ZSchneiderman/SDR-Senior-Design/docs/Video tutorial notes/Samuel_Set_2.jpg

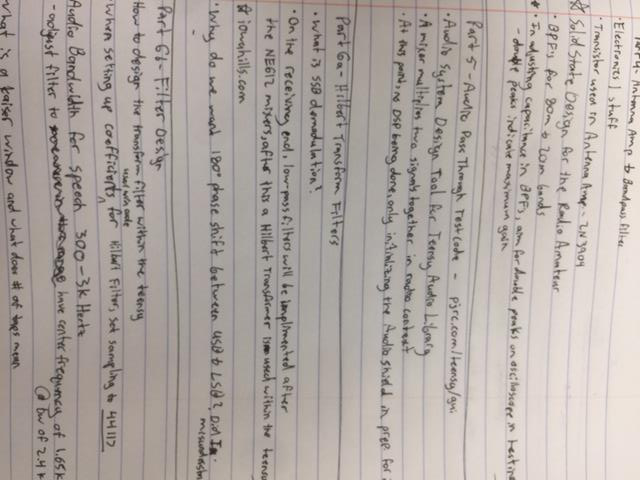
docs/Video tutorial notes/Samuel_Set_2.jpg
