ZSchneiderman/SDR-Senior-Design/docs/Video tutorial notes/Samuel_Set_3.jpg

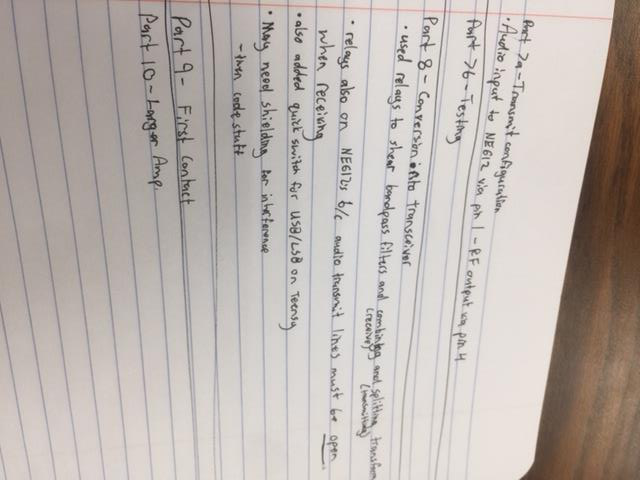
docs/Video tutorial notes/Samuel_Set_3.jpg
