ZSchneiderman/SDR-Senior-Design/docs/SDR_Code/ReadMe.txt

I have uploaded this as a zip file filled with text files because when I try to upload an
arduino file the texas state servers reject it as an "error code 0".
