ZSchneiderman/SDR-Senior-Design/docs/Weekly Reports/1_12_Weekly_12_5_2018.docx

1.12 | Weekly Status Report for Software Defined Radio
| December 5, 2018 | Submitted by: James Bell
| Faculty Advisor: Dr. Stapleton | Team Members: James Bell [PM] Samuel Hussey Zachary Schneiderman
| Sponsor: Texas State University

Green | Current Project Status

We are finalizing things for senior design day. Being the notebook, the mockup circuit, and the poster.

Activities/Accomplishments this week
Team Member | Description
James Bell | I am updating paperwork and compiling the binder for senior design day as well as helping label and compile the parts and sub-assemblies on a demonstration piece.
Samuel Hussey | Completed test plan and prepared documentation for binder.
Zachary Schneiderman | Completed individual report and prepared quadrature generator circuit for display.

Problems Encountered
Severity | Description
High | Still have not received the last of the toroid’s needed for the bandpass filter.
Med | .
Low | .

Activities planned for next week
Team Member | Description
James Bell | Finals.
Samuel Hussey | Assemble and test bp filters if parts arrive.
Zachary Schneiderman | Finish quadrature generator circuit for senior design display.

Upcoming Course Deliverables (next 2 to 3 weeks)
Deliverable | Due Date | Status

Sponsor and Faculty Advisor Meetings Held/Planned
Who | Date | Topic(s)
Dr. Aslan | Wednesdays, 8:20am | Weekly Meeting and discussion on project.
