ZSchneiderman/SDR-Senior-Design/docs/Weekly Reports/1_12_Weekly_11_28_2018.docx

1.12 | Weekly Status Report for Software Defined Radio
| November 28, 2018 | Submitted by: James Bell
| Faculty Advisor: Dr. Stapleton | Team Members: James Bell [PM] Samuel Hussey Zachary Schneiderman
| Sponsor: Texas State University

Green | Current Project Status

We are flying through the initial testing and assembly of our device but being seriously limited in the time we can work on the device due to the amount of paperwork needed of us these last 2 weeks.

Activities/Accomplishments this week
Team Member | Description
James Bell | I am updating paperwork and compiling the binder for senior design day as well as helping label and compile the parts and sub-assemblies on a demonstration piece. I am also writing my individual report.
Samuel Hussey | Worked on test plan and began individual report.
Zachary Schneiderman | Completed rough draft for Senior Design Day poster

Problems Encountered
Severity | Description
High
Med | Still have not received the last of the toroid’s needed for the bandpass filter.
Low | .

Activities planned for next week
Team Member | Description
James Bell | I am preparing for senior design day by completing the mountains of paperwork required of us in this short stretch of time.
Samuel Hussey | Finish test plan/individual report, assemble and test bandpass filters if parts arrive.
Zachary Schneiderman | Need to apply feedback to poster to have it fully ready for senior design day

Upcoming Course Deliverables (next 2 to 3 weeks)
Deliverable | Due Date | Status
Poster final | 11/30/18 | In progress
Test Plan | 11/30/18 | In progress
Individual Reports | 12/3/18 | In progress

Sponsor and Faculty Advisor Meetings Held/Planned
Who | Date | Topic(s)
Dr. Aslan | Wednesdays, 8:20am | Weekly Meeting and discussion on project.
