ZSchneiderman/SDR-Senior-Design/docs/Weekly Reports/1_12_Weekly_10_24_2018.docx

1.12 | Weekly Status Report for Software Defined Radio
| October 24, 2018 | Submitted by: James Bell
| Faculty Advisor: Dr. Stapleton | Team Members: James Bell [PM] Samuel Hussey Zachary Schneiderman
| Sponsor: Texas State University

Yellow | Current Project Status

We built the amplifier we designed using parts available on campus from the parts carts in RFM 5216 and compared the results to the simulation of the same design. The simulation and the actual build did not match at all and the gain dropped dramatically as the frequency was increased. We are researching the possible causes and new designs for the amplifier to eliminate this problem.

Activities/Accomplishments this week
Team Member | Description
James Bell | I am updating the signal flow chart, and submitting orders for parts so we may begin analog testing as soon as our parts are in.
Samuel Hussey | Modifications to functional spec sections. Prepared IDR presentation.
Zachary Schneiderman | Finished functional spec, experimented on a breadboard with amplifier

Problems Encountered
Severity | Description
High | Pre-designed amplifiers do not have the frequency response we desire. The 80m and 40m bandpass filters do not have the roll-off characteristics we desire, so a redesign for all those components is necessary.
Med | We are unsure which type of inductor to get/build for our project as we have received multiple differing opinions on it, we are doing extra research in to it now.
Low | LTSpice testing shows that amplifier maintains gain with increase in frequency but in circuit tests show that in drops significantly.

Activities planned for next week
Team Member | Description
James Bell | Updating the functional schematic to fix errors pointed out in the functional design review, and studying digital signal processing.
Samuel Hussey | Start construction of analog components to begin in circuit testing.
Zachary Schneiderman | Update parts list, and prepare/practice for design review

Upcoming Course Deliverables (next 2 to 3 weeks)
Deliverable | Due Date | Status
Functional Specifications | 10/15/18 | Complete

Sponsor and Faculty Advisor Meetings Held/Planned
Who | Date | Topic(s)
Dr. Aslan | Wednesdays, 8:20am | Weekly Meeting and discussion on project.

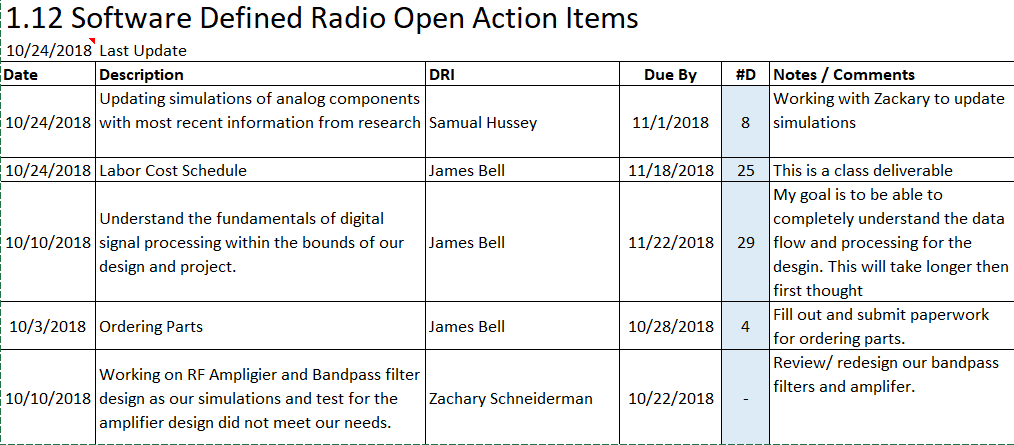
[picture p19: figure]
