ZSchneiderman/SDR-Senior-Design/docs/Block Diagram.docx

LCD

SN74HC74

LPF

LPF

Amp

Mic

Teensy

SI5351

Audio Shield

Encoder

Amp

Ant.

Audio Transformer1k:1k in 600:600 out

Audio Transformer1k:1k in 600:600 out

Mixer

Mixer

RF Splitter/Combiner

BP Filter
