ZSchneiderman/SDR-Senior-Design/docs/Weekly Reports/1_12_Weekly_9_19_2018.pdf

# 1.12 Weekly Status Report for Software Defined Radio

September 19, 2018 | Submitted by: James Bell
Faculty Advisor: Dr. Stapleton | Team Members: James Bell [PM] Samuel Hussey Zachary Schneiderman

Sponsor: Texas State University

# Green Current Project Status

We have compiled the statement of work and will be getting it signed and finalized then the next set of necessary actions as of Wednesday 9/24/2018.

# Activities/Accomplishments this week

Team Member | Description
James Bell | Filled out project manager forms, documentation, started research in to
the Arduino testing environment and possible methods of testing the code provided with an actual micro controller.
Samuel Hussey | Began piecing together block diagrams to start working schematic in
LTSpice. Started building/finding components on LTSpice that are not originally included (mixers and antenna specifically).
Zachary Schneiderman Took notes and did research on unknowns from Charlie Morris’s SDR project, particularly Class B Amplifier design and quadrature audio signals

# Problems Encountered

Severity | Description
High | Not sure how to model/replace Teensy or audio board in LTSpice in
order to finish working model. Med
Low | How to use Piazza to upload and maintain documentation for the
project.

# Activities planned for next week

Team Member | Description
James Bell | Submit final signed version of the statement of work, then work out the
Arduino environment for code implementation and testing.
Samuel Hussey | Continue work on schematic by finishing finding/building any
components necessary and then implementing them into the schematic.

Zachary Schneiderman Start on first draft for parts list, need to do more research quadrature on refresh my self on DSP filters and transforms

# Upcoming Course Deliverables (next 2 to 3 weeks)

Deliverable | Due Date | Status
SOW | 9/24/2018 | In progress

# Sponsor and Faculty Advisor Meetings Held/Planned

Who | Date | Topic(s)
Dr. Aslan | Wednesdays, 8:20am | Weekly Meeting and discussion on project.

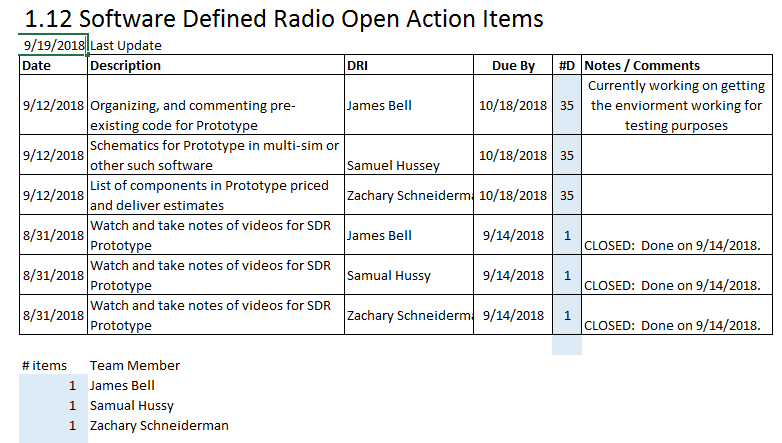
[picture p27: figure]

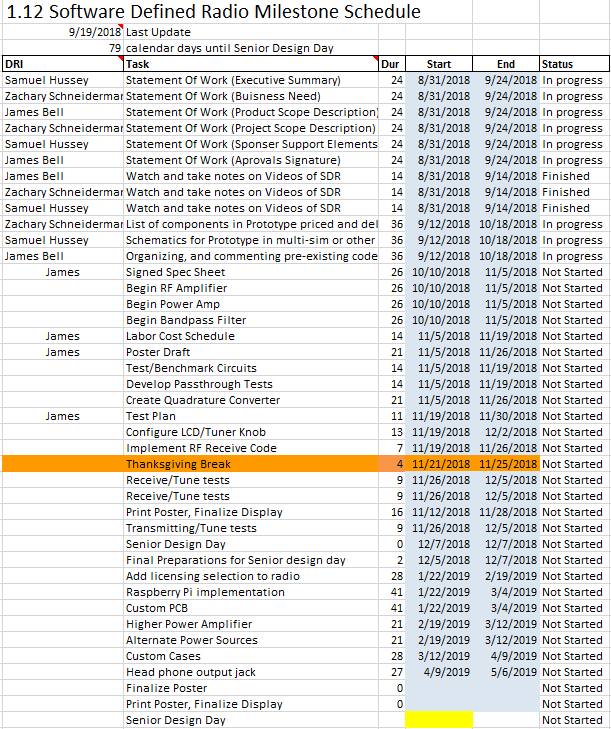
[picture p28: figure]
