ZSchneiderman/SDR-Senior-Design/docs/Weekly Reports/1_12_Weekly_9_26_2018.pdf

# 1.12 Weekly Status Report for Software Defined Radio

September 26, 2018 | Submitted by: James Bell
Faculty Advisor: Dr. Stapleton | Team Members: James Bell [PM] Samuel Hussey Zachary Schneiderman

Sponsor: Texas State University

# Green Current Project Status

We have submitted the statement of work and are now starting on our individual tasks as assigned in the action items.

# Activities/Accomplishments this week

Team Member | Description
James Bell | Downloaded, compiled, and began testing the Arduino environment.
Samuel Hussey | Continued progress on working schematic in LTSpice and began testing
amplifiers
Zachary Schneiderman Tried reading about quadrature audio, more complicated than thought

# Problems Encountered

Severity | Description
High | Not sure how to model/replace Teensy or audio board in LTSpice in
order to finish working model. Med
Low | .

# Activities planned for next week

Team Member | Description
James Bell | Begin reviewing the code provided and start working on implementing it
in the Arduino coding environment.
Samuel Hussey
Finish all diagrams and have specific components in place. Zachary Schneiderman Begin work on the parts list, ideally finish it

# Upcoming Course Deliverables (next 2 to 3 weeks)

Deliverable | Due Date | Status
SOW | 9/24/2018 | Completed

Functional

Specifications | 10/15/18 | In Progress

# Sponsor and Faculty Advisor Meetings Held/Planned

Who | Date | Topic(s)
Dr. Aslan | Wednesdays, 8:20am | Weekly Meeting and discussion on project.

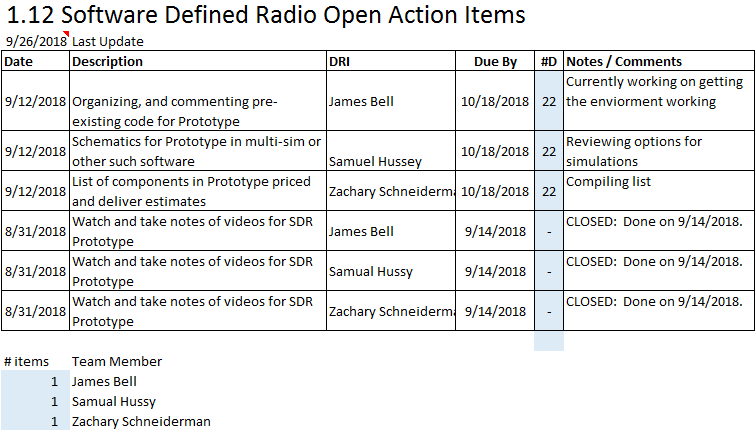
[picture p29: figure]

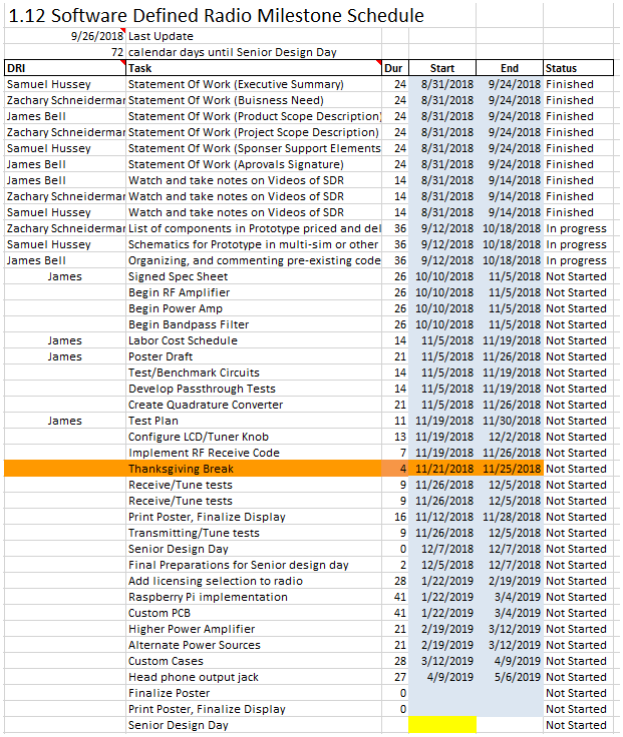
[picture p30: figure]
