ZSchneiderman/SDR-Senior-Design/docs/Weekly Reports/1_12_Weekly_9_12_2018.pdf

# 1.12 Weekly Status Report for Software Defined Radio

September 12, 2018 | Submitted by: James Bell
Faculty Advisor: Dr. Stapleton | Team Members: James Bell [PM] Samuel Hussey Zachary Schneiderman

Sponsor: Texas State University

# Green Current Project Status

We have delegated the statement of work out to individual team members and will be comparing rough drafts of each segment Wednesday 9/12/2018 to critique them, correct them and then send them to Dr. Aslan and Dr. Stapleton for review.

# Activities/Accomplishments this week

Team Member | Description
James Bell | Filled out project manager forms, documentation, completed the rough
draft of my section and found the prototype makers blog with rough documentation of the prototype.
Samuel Hussey | Worked on executive summary and sponsor support elements of
statement of work. Began research on mixers and filtering for receiver portion of radio.
Zachary Schneiderman Worked on first draft for the Business Need and Project Description sections of the statement of work. Started research on efficient amplifiers, and construction of custom inductors.

# Problems Encountered

Severity | Description
High | Charlie Morris is very Australian and his accent and the speed with which
he talks makes following the videos accurately difficult. Med
Low | Another series of Charlie Morris is more descriptive and in-depth, but
does not follow exactly what we will be constructing, so trying to translate the other projects design, to our own.

# Activities planned for next week

Team Member | Description
James Bell | Complete final Draft of assigned segments for the Statement of work,
and compile to finalized version of the statement of work for submission.

Samuel Hussey | Complete final draft of assigned segments of statement of work, start
constructing schematics in LTSpice.
Zachary Schneiderman Complete final draft of assigned sections of the Statement of Work. Start preparing parts list, and ensure everyone can set up the Arduino Suite.

# Upcoming Course Deliverables (next 2 to 3 weeks)

Deliverable | Due Date | Status
SOW | 9/24/2018 | In progress

# Sponsor and Faculty Advisor Meetings Held/Planned

Who | Date | Topic(s)
Dr. Stapleton | 9/6/2018 | Statement of Work advice, expectations, and commentary

Dr. Aslan and Dr.

Stapleton | 9/14/2018 | Statement of Work review

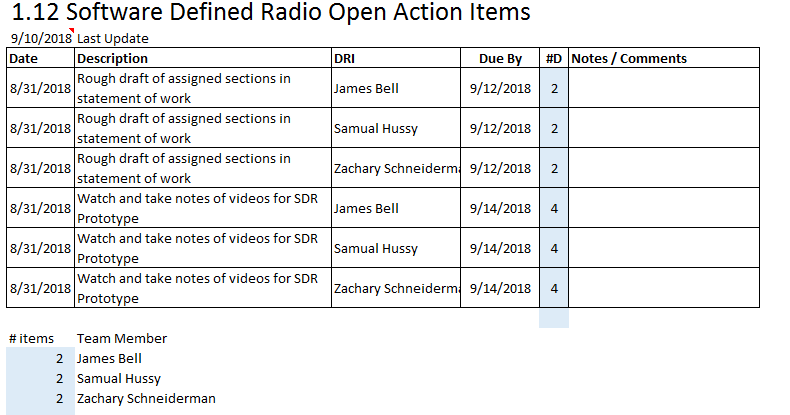
[picture p31: figure]

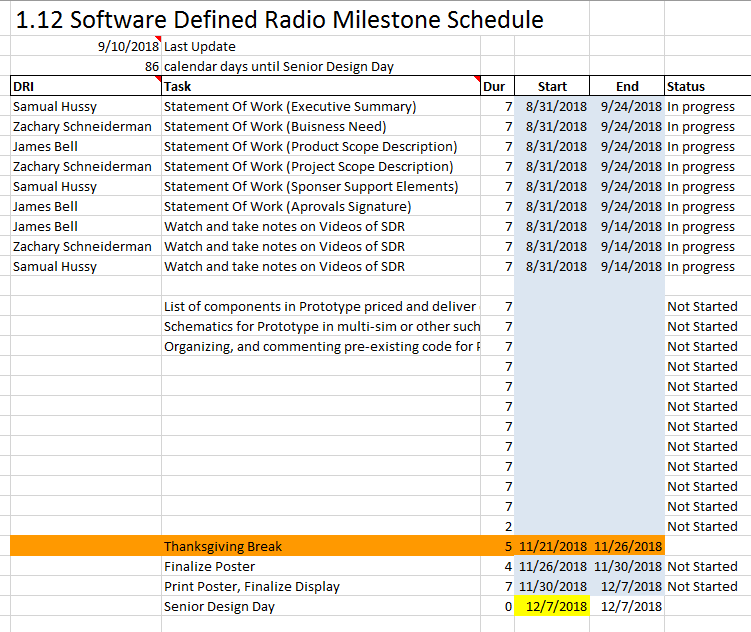
[picture p32: figure]
