ZSchneiderman/SDR-Senior-Design/docs/Labor Cost Schedule/Labor-Cost-Schedule Team 1.12.docx

Labor, Cost & Schedule Document

Software defined radio

Project Manager: James Bell

Samuel Hussey, Zachary Schneiderman

Texas State University

Ingram School of Engineering

SPONSOR Texas State University

601 University Drive

San Marcos, Texas, 78666

11/1/2018

Texas_State_Primary_V_2color

# 1 Introduction & Summary

In this Project the end goal is an operational software defined radio for educational

purposes. It will be a half-duplex device operating in the North American High

Frequency Range as allocated by the North American International Telecommunications Union. The radio will be completed by May 1st, 2019. The estimated cost for Labor is $52,016.48 and the estimated cost for Materials is $200.

# 2 Labor

## 2.1 Labor Categories

Project Labor Categories
Labor Category | Justification
Design Engineer | Optimization of radio frequency interactions with and between components.
Lawyer specializing in the FCC | Radio communications in the united states are regulated, and many laws apply to their use, it is important to know exactly what all of those are and how to go about designing the radio within legal bounds
Digital Signal Processing Engineer | As much of the fundamental filtering and operation of the radio will be done inside the digital realm of the
Test Engineer | Verifying the design is operating correctly and with in applicable law.
Technical Writer | Create a detailed and user-friendly user manual for device.
Technician | This will be necessary of a build kit goes in to production. A technician will need to be present to keep an eye on the production line.
Fabricator/Assembler | Needed to assemble the prototypes for testing.
Drafting / CAD | Creating clear and concise schematics for the user’s manual.
Marketing Analyst | Identifying the best methods to market the radio to those whom would be interested in buying it.
Administrative | Not needed as the device does not have administrative access.
Management / Supervision | Organizing contracts, setting time tables for stages of project, and facilitating funding.
Digital Signal Processing specialist | Need to create and optimize the digital signal processing done inside the device to limit radio latency.
Consulting | Not needed
Contractor | Not needed
Janitorial Services | Keeping a clean work space is very important to productivity, no one wants to work surrounded by filth.

## 2.2 Labor Rates

I have listed the burdened hourly cost as double the average hourly wage for each of those job titles in the united states as these tasks are not going to take a particularly long time. Meaning each of these jobs will not take an entire year thus hiring by task with a short term contract makes more economic sense then hiring for an entire year.

Labor Categories and Burdened Hourly Costs
Labor Category | Burdened Hourly Cost | Justification
Design Engineer | $77.06 | On average Radio Frequency design engineers make $80,140 a year, as this device should not take more then a year in development and testing, and the engineer will not be needed for that time it could be a short-term contract. Unfortunately, those type of contracts tend to be more hourly then the annual salary, thus the burdened hourly cost.
Lawyer specializing in the Federal Communications Commission | $114.63 | As this radio is being designed for the United states market it is important all laws, rules, and regulations are followed. To do this a lawyer specializing in those things with respect to the FCC is necessary for a legal radio.
Digital Signal Processing Engineer | $82.55 | As the fundamental filtering and operation of this device takes place digitally through digital signal processing this job is necessary and vital.
Test Engineer | $63.80 | Detailed and extensive testing of radios are necessary to ensure the radio meets federal and state laws and fall within those limits and bounds.
Technical Writer | $70.35 | A technical writer is vital whether we are making a build kit or just posting schematics for sale because if few can understand the design, then few will buy or build it. As this is not a project that needs full time employment paying for a contract-based job at the burden rate could be cheaper over all.
Technician | $41.17 | This cost will only be necessary if a radio build kit for our design goes in to production, but if it does it is important the production line does not go down, thus the Technician for as long as is needed.
Fabricator / Assembler | $30.77 | This person can be brought on as needed for hourly pay or a contract job, This persons duty is to assemble one or a set number of radios for testing, and as that number is variable and the time required may be limited the burdened hourly cost could be manageable.
Drafting / CAD | $52.16 | This job is necessary for the creation of schematics for this radio, as the placement of the components will affect the radios harmonics, and internal radio frequency interference this person should work closely with the radio frequency design engineer for placement and many of these schematics will be presented to the user to facilitate assembly. Thus, paying the burdened hourly cost to keep on a qualified and competent Drafter is vital.
Marketing Analyst | $60.15 | This job is important as it will provide information as to where to market our radio to attract the intended audience. Having a market analyst is important for the product to even get off the ground.
Administrative | ----- | This job is not required as administrative access for this radio does not exist.
Management / Supervision | $64.44 | Organizing contracts, setting time tables for stages of the project, and facilitating funding are all things necessary to the completion and distribution of the radio, Thus having one person whom the team can turn to for leadership and consistency is important.
Janitor | $27.71 | This is important to keep the work space clean and sanitary.

## 2.3 Total Cost of Labor

# 3 Materials

## 3.1 Capital Expenses

CAPITAL EXPENDITURE ESTIMATE
Task | Materials | Cost
Project Test | Mixed Signal Oscilloscope | $5,500¹
| Spectrum Analyzer | $8,000¹
TOTAL | | $13,500

¹ Available from Sponsor

² Available at Texas State University

## 3.2 Non-Capital Expenses

NON-CAPITAL EXPENDITURE ESTIMATE
Task | Materials | Cost
Project Fabrication | Soldering Station | $150
| Solder kit | $20
| Cables | $100
| IC's | $50
| Perf Board | $40
Project Test | Variable Power Supply (DC) | $200
| Function Generator (DC+AC) | $800
TOTAL | | $1360

# 4 Total Project Cost

PROJECT LABOR & MATERIALS COST SUMMARY
Cost Category | Estimated Cost
Labor | $52,016.48
Capital Expenses | $13,500.00
Non-Capital Expenses | $136.00
TOTAL ESTIMATED PROJECT COST | $65,652.48

# 6 Project Schedule

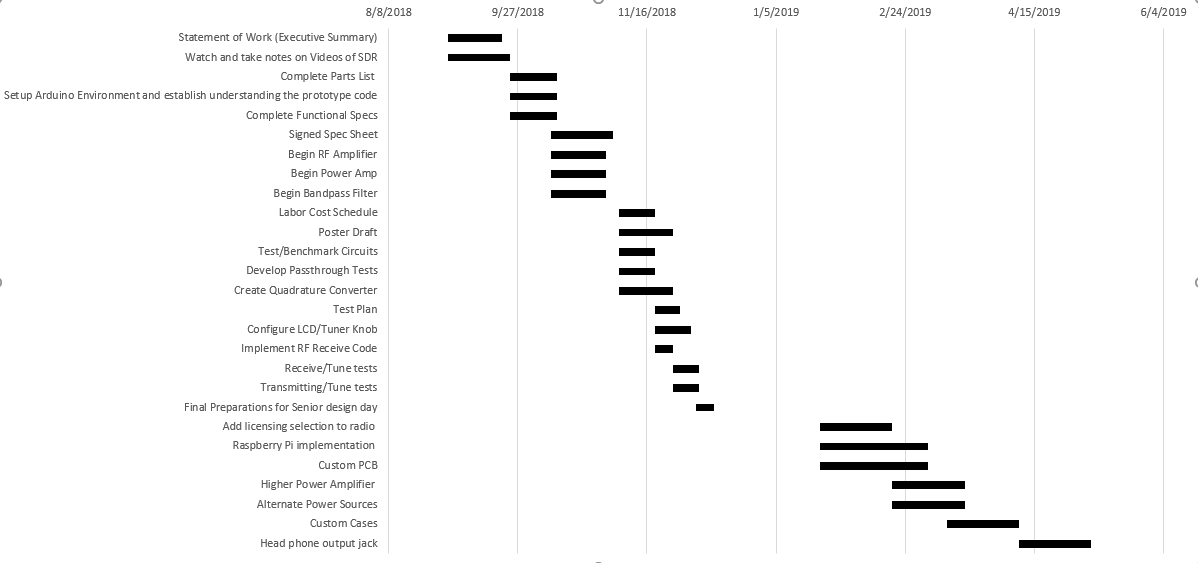
[picture p40: figure]

# 7 Approvals

Approver Name | Title | Signature | Date
| Project Manager
| D2 Project Manager
