ZSchneiderman/SDR-Senior-Design/docs/Labor Cost Schedule/Labor_Cost_Schedule.xlsx

Labor Estimate
 | Radio Freqency Design Engineer | Lawyer specializing in The FCC | Digital Signal Processing Engineer | Test Engineer | Technical Writer | Technician | Fabricator/Assembler | Drafting/CAD | Marketing Analyst | Management/Supervison | Cleaning/ Janitorial services | Total cost per stage
Burdened Hourly Rate | $77.06 | $114.63 | $82.55 | $63.80 | $70.35 | $41.17 | $30.77 | $52.16 | $60.15 | $64.44 | $27.71
Task | Hours Required
Project Definition | 40 | 40 |  |  |  |  |  |  | 10 | 22.5 |  | $9719.00
Legal documents | 4 | 60 |  |  |  |  |  |  | 4 | 17 |  | $8522.12
Functional Specification | 40 | 4 | 40 |  | 8 |  |  | 10 |  | 25.5 |  | $9570.54
Simulations | 10 |  | 40 | 6 |  |  |  |  |  | 14 |  | $5357.56
Test Plan | 20 |  | 20 | 40 | 8 |  |  |  |  | 22 |  | $7724.68
Prototype Assembly |  |  |  |  |  | 16 | 20 |  |  | 9 |  | $1854.08
Characterization | 10 |  |  | 40 |  |  |  |  |  | 12.5 |  | $4128.10
User Manual |  | 4 |  |  | 10 |  |  | 30 | 10 | 13.5 |  | $4198.26
Cleaning Services |  |  |  |  |  |  |  |  |  |  | 34 | $942.14
 |  |  |  |  |  |  |  |  | Total Burdened Cost = |  |  | $52016.48
Total number of hours in project = |  |  | 680
