ZSchneiderman/SDR-Senior-Design/docs/Video tutorial notes/Zach.pdf

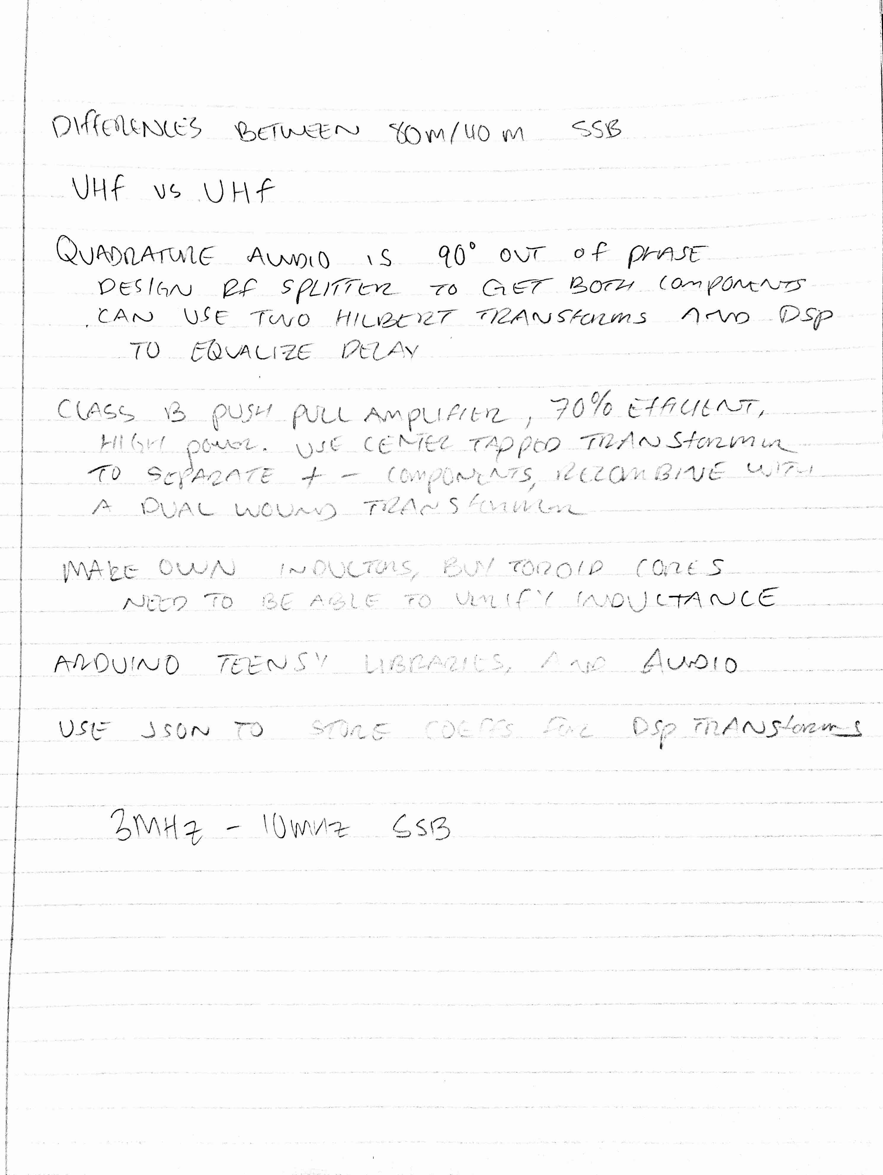
[picture p41: page 1]
