ZSchneiderman/SDR-Senior-Design/docs/Video tutorial notes/Samuel_Set_1.jpg

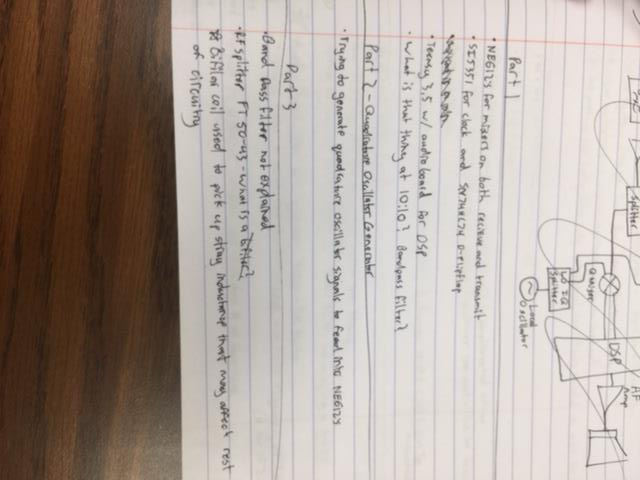
docs/Video tutorial notes/Samuel_Set_1.jpg
