ZSchneiderman/SDR-Senior-Design/(threads)

Thread 3 (2018-09-06):

Circuit Schematics

ZSchneiderman, 2018-09-06:
Need to create schematics for the teensy audio circuit, audio amplifier, microphone amplifier, digital to analog converters, filters, etc
