ZSchneiderman/SDR-Senior-Design/docs/Signal Flow Chart.pdf

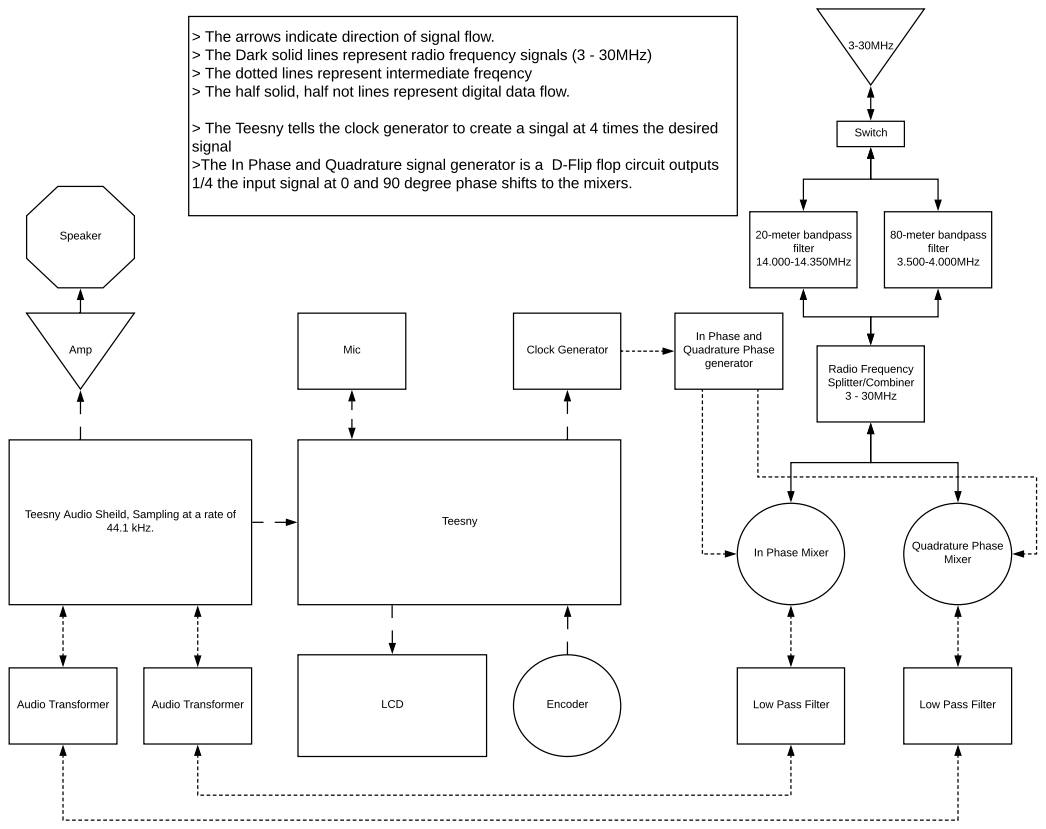
[picture p44: page 1]
3-30MHz; Switch; 20-meter bandpass filter 14.000-14.350MHz; 80-meter bandpass filter 3.500-4.000MHz; Radio Frequency Splitter/Combiner 3 - 30MHz; In Phase Mixer; Quadrature Phase Mixer; Audio Transformer; Low Pass Filter; 44.1 kHz.; Teesny; LCD; Encoder; Clock Generator; Amp; Mic; Speaker

> The arrows indicate direction of signal flow.
> The Dark solid lines represent radio frequency signals (3 - 30MHz)
> The dotted lines represent intermediate freqency
> The half solid, half not lines represent digital data flow.

> The Teesny tells the clock generator to create a singal at 4 times the desired
signal
>The In Phase and Quadrature signal generator is a D-Flip flop circuit outputs
1/4 the input signal at 0 and 90 degree phase shifts to the mixers.

In Phase and
Quadrature Phase
generator

Teesny Audio Sheild, Sampling at a rate of
