ZSchneiderman/SDR-Senior-Design/docs/LTspice schematics/7v_Regulator.asc

R1: res; 1000
R2: res; 220
X1: LM317T
Named nets: 7V_+, 12V_+, 0
