ZSchneiderman/SDR-Senior-Design/docs/LTspice schematics/80m_20m BPFs.asc

X1: 
X2: 
X3: 
X4: 
Named nets: Control_From_Teensy_Pin_30, Filtered_RF_out, Control_From_Teensy_Pin_31
