ZSchneiderman/SDR-Senior-Design/docs/LTspice schematics/Antenna & Amp.asc

C1: cap; 100n
C4: cap; 10n
C10: cap; 100n
Cb1: cap; 100n
L1: ind; 1mH
Q1: npn; 2N3904
R1: res; 10k
R2: res; 2k
R3: res; 2.2k
R5: res; 10k
RE1: res; 120
V1: voltage; 12V
Vs1: voltage; SINE(0 5uV 3.7e6 0 0 0); AC 1 0
X1: 
Named nets: 0, RF_Output, RF_Transmit_From_Mixing_Circuit, Control_From_Teensy_Pin_32
Antenna
RF Amp
