ZSchneiderman/SDR-Senior-Design/docs/LTspice schematics/Audio_Amp_to_Speaker.asc

X1: Audio_Amplifier
X2: Speaker
Named nets: AF_From_Mixing_Circuit, 5V_Source_+, gnd
