ZSchneiderman/SDR-Senior-Design/docs/LTspice schematics/LP_Filter.asc

C1: cap; 100n
C2: cap; 100n
L1: ind; 1m
Named nets: IN, Out, 0
