ZSchneiderman/SDR-Senior-Design/docs/LTspice schematics/Mixing Circuit.asc

C1: cap; 100n
C2: cap; 100n
C3: cap; 10µ
C4: cap; 10µ
C5: cap; 100n
C6: cap; 100n
R1: res; 4.7k
R2: res; 4.7k
X1: 
X2: 
X3: 
X4: 
X5: 
X6: 
X7: 
X8: 
X9: 
Named nets: Audio_Frequency_to_Audio_Amp, Filtered_RF_Input, RF_Transmit_to_Relay, 5V, Teensy_Pin_18, Teensy_Pin_19
