ZSchneiderman/SDR-Senior-Design/docs/LTspice schematics/SDR Transceiver Full.asc

X1: 
X2: 
X3: 
X4: 
X5: 
X6: 
X7: 
X8: 
Named nets: 5V
