ZSchneiderman/SDR-Senior-Design/docs/LTspice schematics/splitter_combiner.asc

Lp: ind2; 9025µ
Ls1: ind2; 25µ
Ls2: ind2; 25µ
Named nets: 0, IN1, IN2, OUT1, OUT2
K Lp Ls1 Ls2 1
The actual splitter/combiner is a toriod wrapped with a 8:8 turn ratio. One wrapping done with a single wire and one done with two twisted wires.
