ZSchneiderman/SDR-Senior-Design/docs/LTspice schematics/20m BP.asc

C1: cap; 492p
C2: cap; 50p
C5: cap; 492p
L1: ind; 0.32µ
L2: ind; 0.32µ
L5: ind; 2.67µ
Named nets: 0, IN, OUT
20m
