ZSchneiderman/SDR-Senior-Design/docs/LTspice schematics/80m BP.asc

C1: cap; 2.2n
C2: cap; 200p
C3: cap; 2.2n
L1: ind; 1µ
L2: ind; 1µ
L3: ind; 10µ
Named nets: IN, OUT, 0
80m
