ZSchneiderman/SDR-Senior-Design/docs/LTspice schematics/Relay_with_control.asc

D1: diode; 1N4004
X1: Relay
X2: Transistor_switch_(powerAMP_for_Teensy_to_relay)
Named nets: 5V_+, Control_From_Teensy, Signal_1, Singal_2, Signal_3, 0
