ZSchneiderman/SDR-Senior-Design/docs/LTspice schematics/Transistor_Switch_(powerAMP_for_Teensy_to_relay).asc

Q1: npn
Named nets: Base, Emitter, Collector
