ZSchneiderman/SDR-Senior-Design/docs/LTspice schematics/SDR Transciever schematics for presentation 4_1_2019/7v_Power_Regulator.asc

R1: res; 1000
R2: res; 220
X1: LM317T
Named nets: 12V_-, 7V_-, 7V_+, 12V_+
