ZSchneiderman/SDR-Senior-Design/docs/LTspice schematics/SDR Transciever schematics for presentation 4_1_2019/Audio_AMP_With_Speaker.asc

X1: Audio_Amplifier
X2: Speaker
Named nets: From_Teensy_Audio_Sheild_L, From_Teensy_Audio_Sheild_R, 5V_Source_+, 5V_Source_-
