ZSchneiderman/SDR-Senior-Design/docs/LTspice schematics/SDR Transciever schematics for presentation 4_1_2019/LowPass_Filter.asc

C1: cap
C2: cap
L1: ind
Named nets: IN, Out, 0
