ZSchneiderman/SDR-Senior-Design/(commit log)

2018-09-30 Statements of work
    Current statements of work as of 9/30/18
2018-10-17 Most recent Sch
    [Weekly_Project_Schedule_Software_Defined_Radio.xlsx]
2018-10-31 Updated Files 10/31/2018
    Action items, Meeting Attendance, Weekly schedule
    [Action_Item_Software_Defined_Radio.xlsx, Team Meeting Attendance Form _Software Defined Radio_.xlsx, Weekly_Project_Schedule_Software_Defined_Radio.xlsx]
2018-11-04 Labor cost Schedule file
    In this file I have done some sections of the labor cost schedule, created the asked for excel spreadsheet for what ever it was in section 2, and Posted the links to Gantt charts, as well as the template.
    [Labor_Cost_Schedule.xlsx]
2018-11-28 Final Poster? and Updated Weekly schedule
    [Weekly_Project_Schedule_Software_Defined_Radio.xlsx]
2019-02-04 Updated important documents
    I updated the schedule, attendance, and action items for the project
    [Action_Item_Software_Defined_Radio.xlsx, Team Meeting Attendance Form _Software Defined Radio_.xlsx, Weekly_Project_Schedule_Software_Defined_Radio.xlsx]
2019-02-06 2/6/2019 updated
    [Team Meeting Attendance Form _Software Defined Radio_.xlsx, Weekly_Project_Schedule_Software_Defined_Radio.xlsx]
2019-02-25 Project Update
    [Team Meeting Attendance Form _Software Defined Radio_.xlsx, Weekly_Project_Schedule_Software_Defined_Radio.xlsx]
2019-05-05 Create Final Schematics 5_5_2019
2019-05-05 Final Schematics 5_5_2019
